rzo42/LITTLE-BM/LITTLE_BM_scematic.png

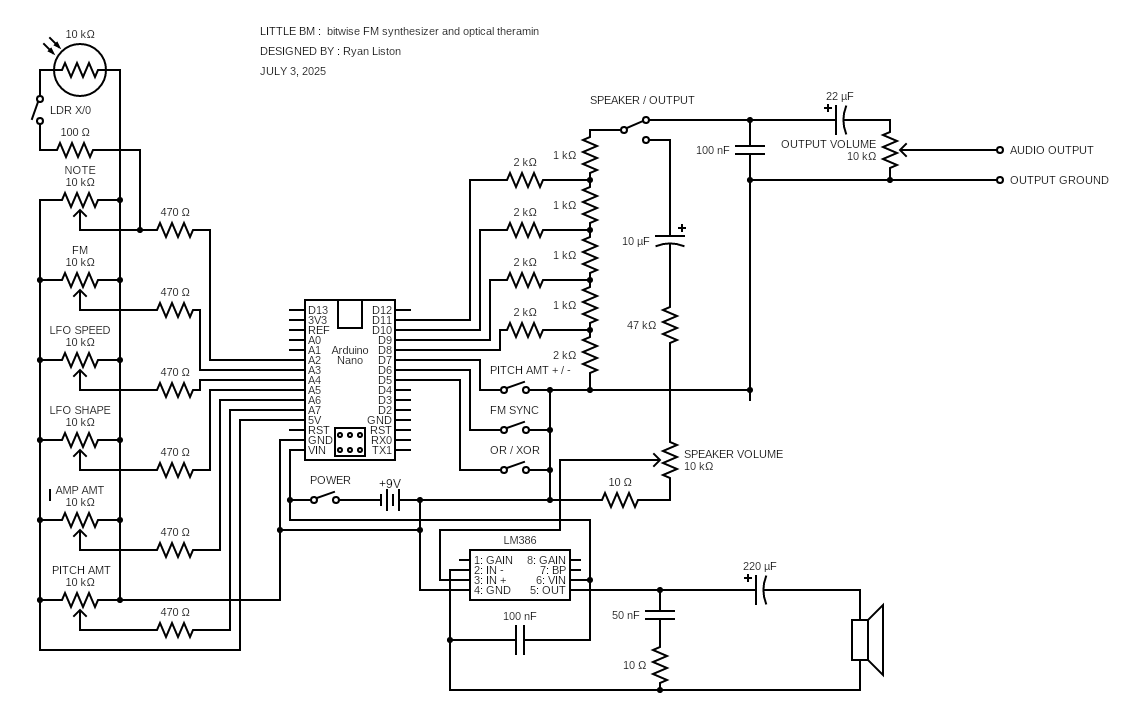
LITTLE_BM_scematic.png
